SteveMayze/LED_Chain/doc/20201027_183659.jpg

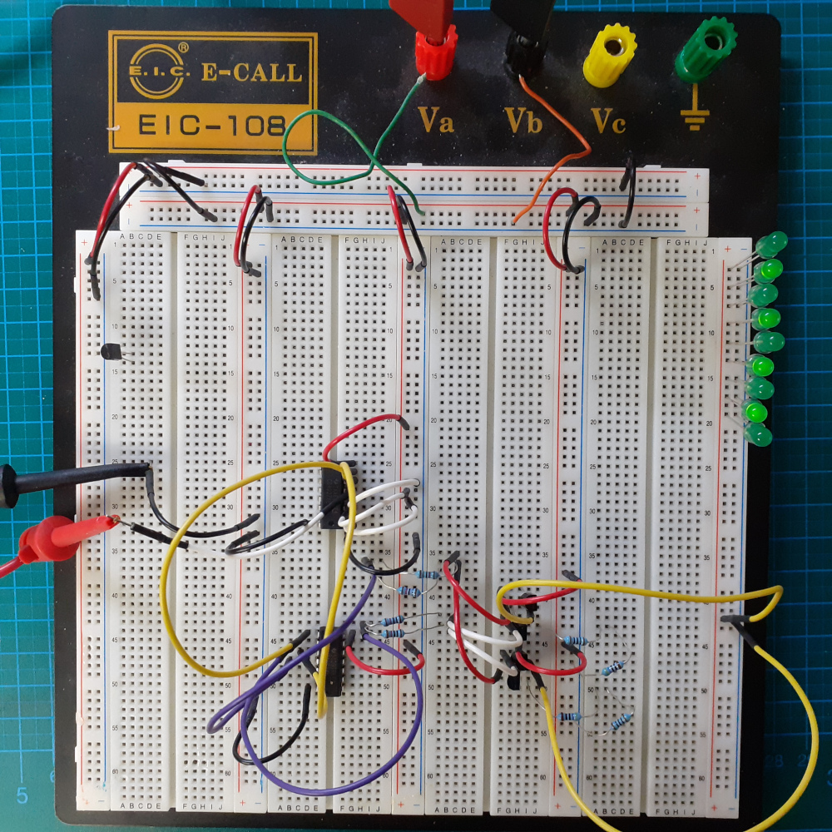
doc/20201027_183659.jpg
