SteveMayze/LED_Chain/doc/2021-10-09_17-44-00.jpg

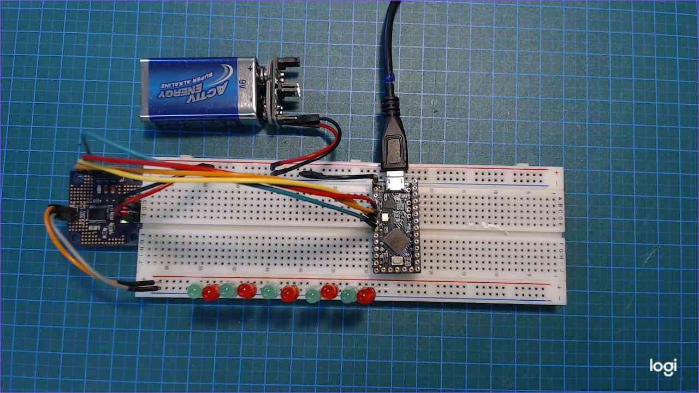
doc/2021-10-09_17-44-00.jpg
