SteveMayze/LED_Chain/README.md

# LED_Chain
An experiment in driving a chain of LEDs
