SteveMayze/LED_Chain/doc/2021-09-12_13-22-11.jpg

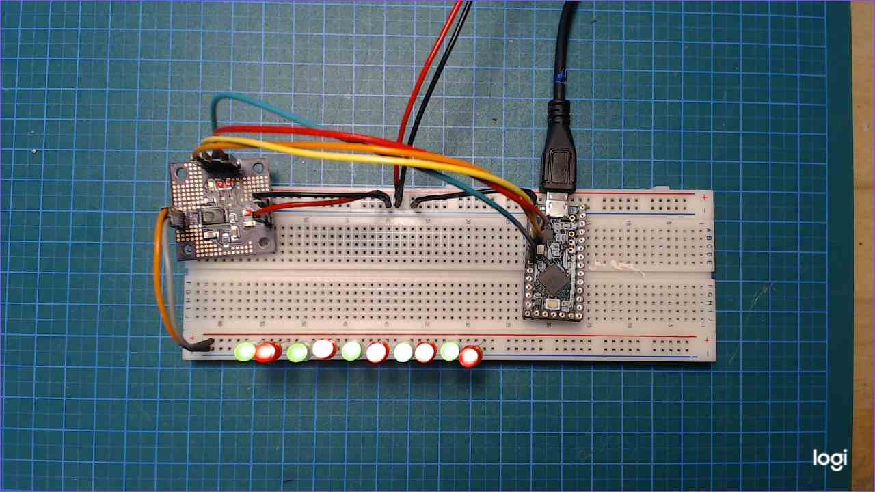
doc/2021-09-12_13-22-11.jpg
