SteveMayze/LED_Chain/doc/20201024_185740.jpg

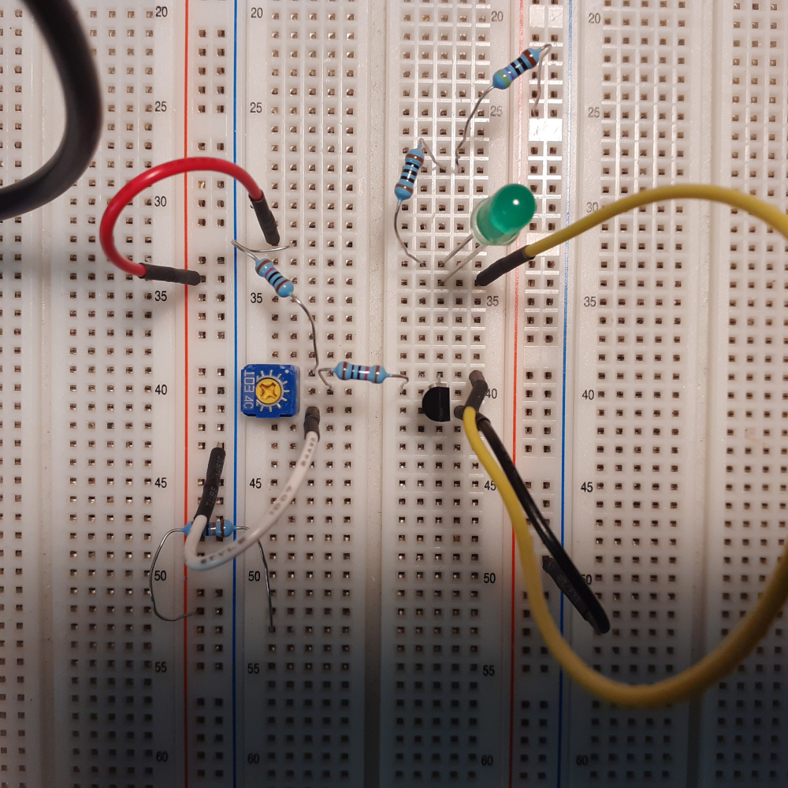
doc/20201024_185740.jpg
