SteveMayze/LED_Chain/doc/20201025_183352.jpg

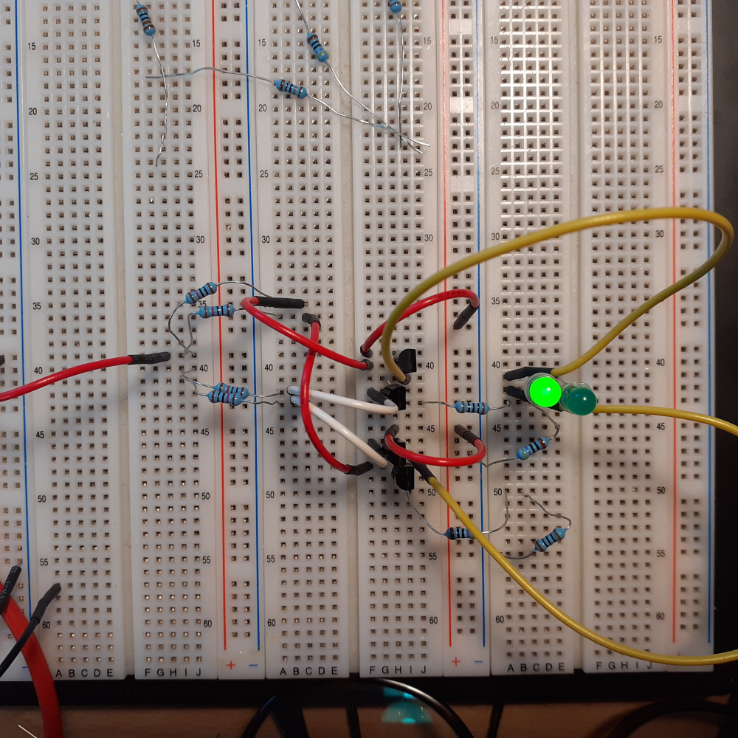
doc/20201025_183352.jpg
