SteveMayze/LED_Chain/doc/BreathPulse.png

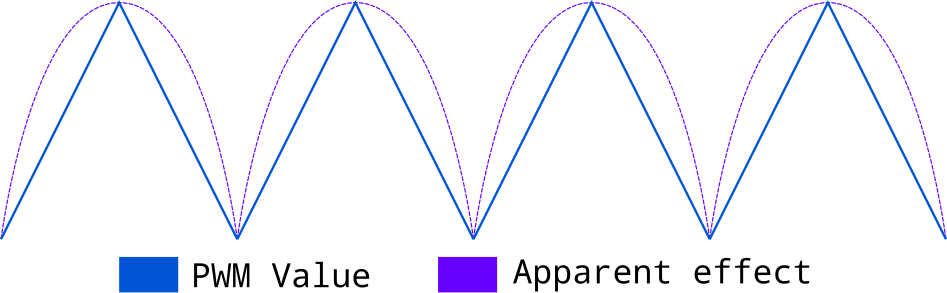
doc/BreathPulse.png
