SteveMayze/LED_Chain/doc/Falstad-Circuit.png

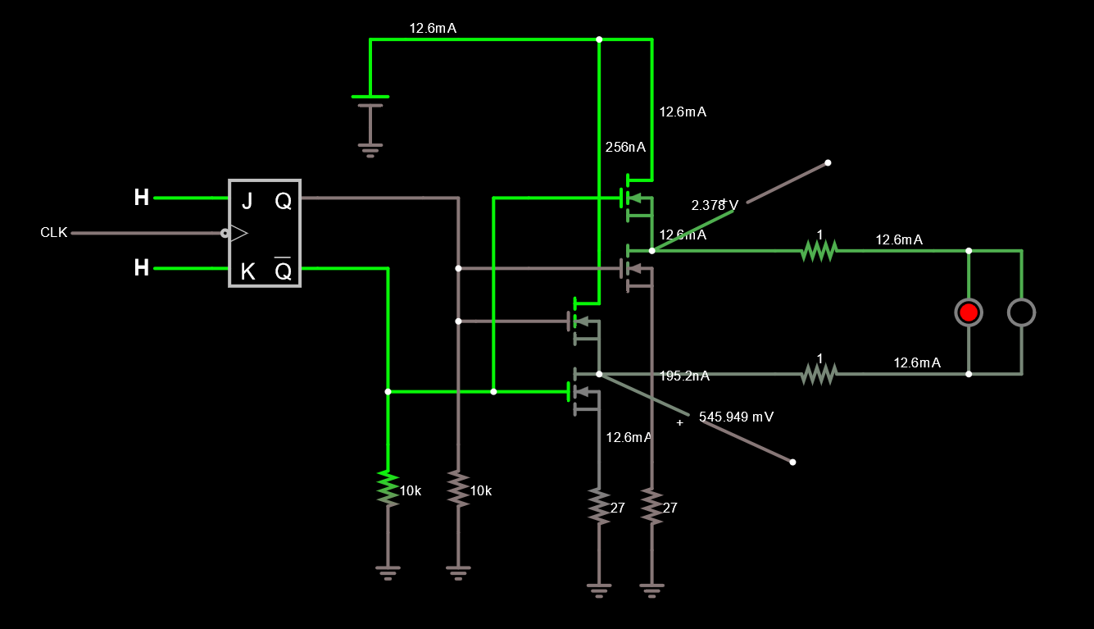
doc/Falstad-Circuit.png
