SteveMayze/LED_Chain/doc/LED_Chain_Bus.png

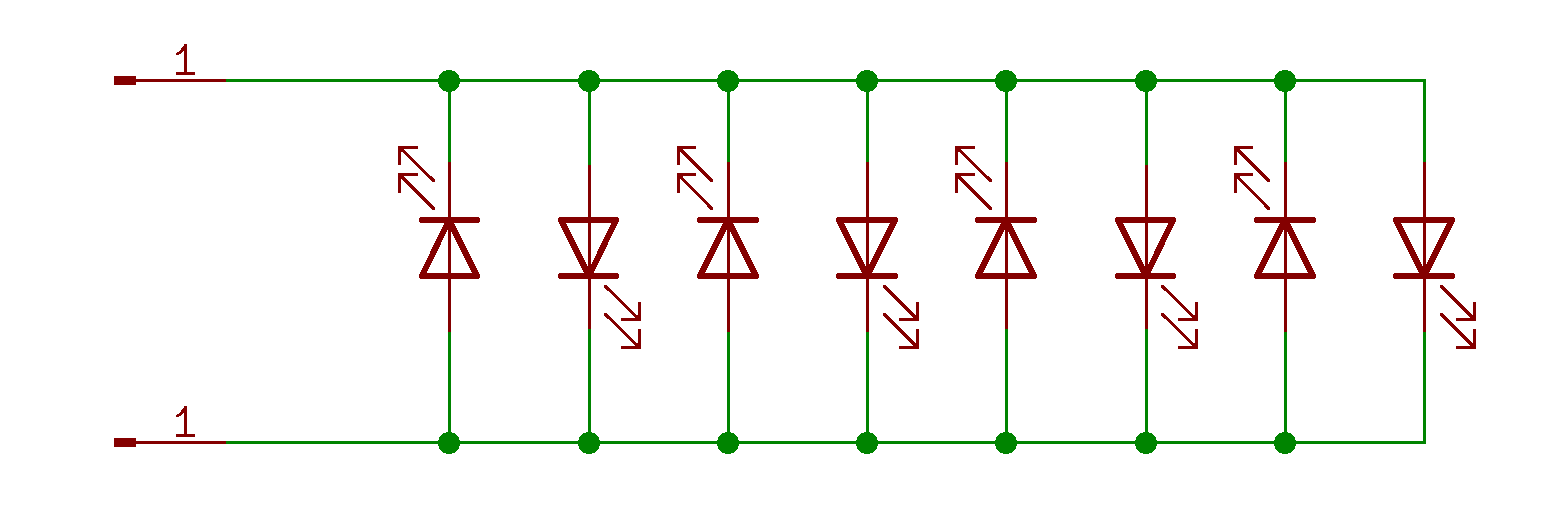
doc/LED_Chain_Bus.png
