SteveMayze/LED_Chain/doc/R_LED_Calc.png

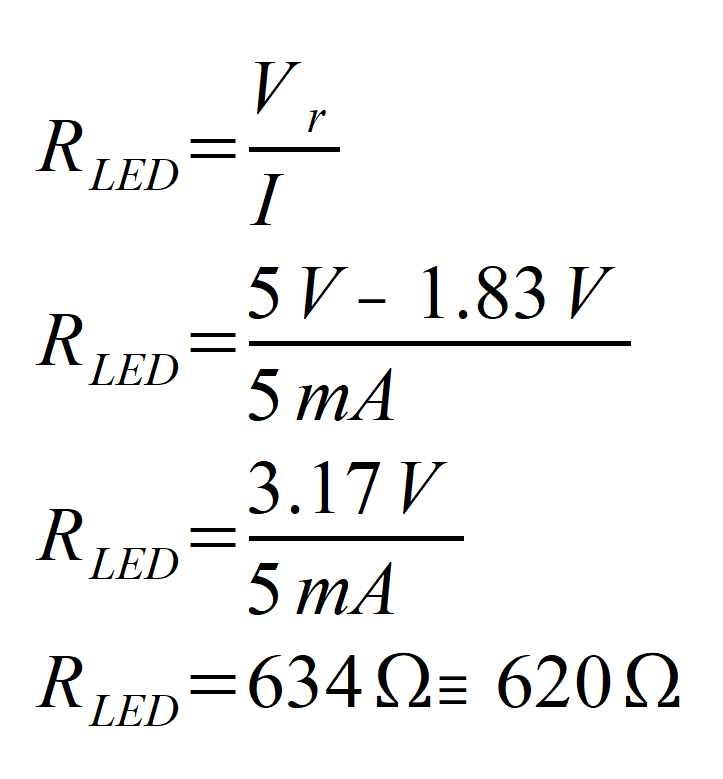
doc/R_LED_Calc.png
