SteveMayze/LED_Chain/Fritzing/motorDriver.png

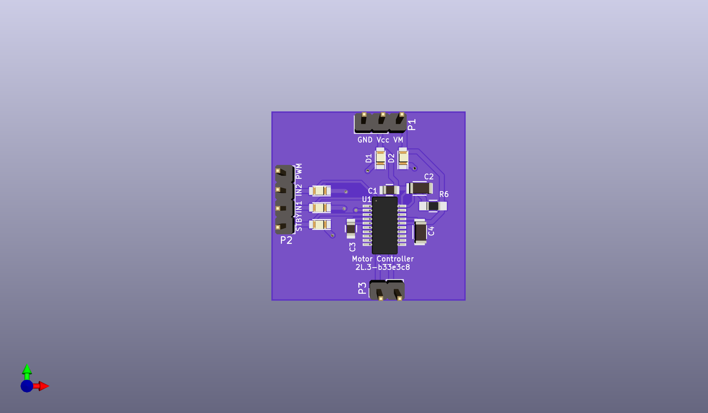
Fritzing/motorDriver.png
