SteveMayze/LED_Chain/Fritzing/Teensy Gogogo Connection_bb.png

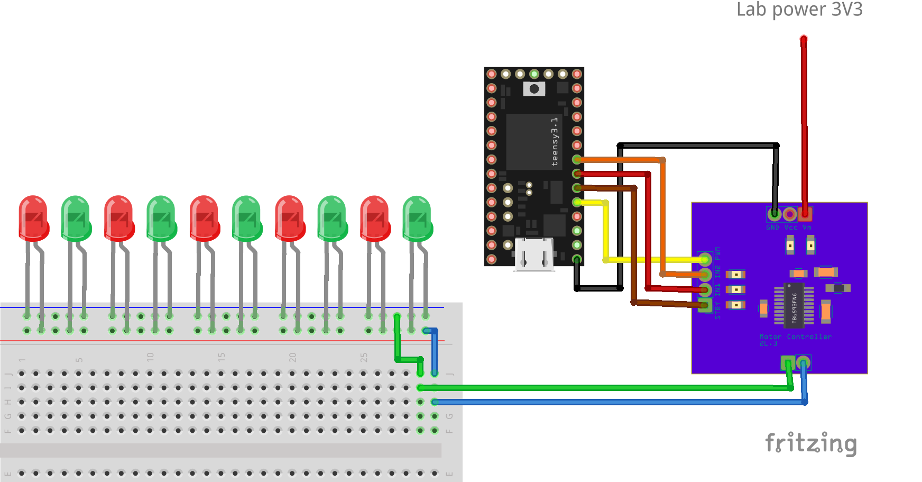
Fritzing/Teensy Gogogo Connection_bb.png
