SteveMayze/LED_Chain/(list of files, drawings)

Other design files:
Fritzing/Fzz/Teensy Gogogo Connection.fz
Fritzing/Teensy Gogogo Connection.fzz
