SteveMayze/LED_Chain/kicad/LED_Chain.kicad_pcb

## KiCad design kicad/LED_Chain.kicad_pcb (2024-11-23)

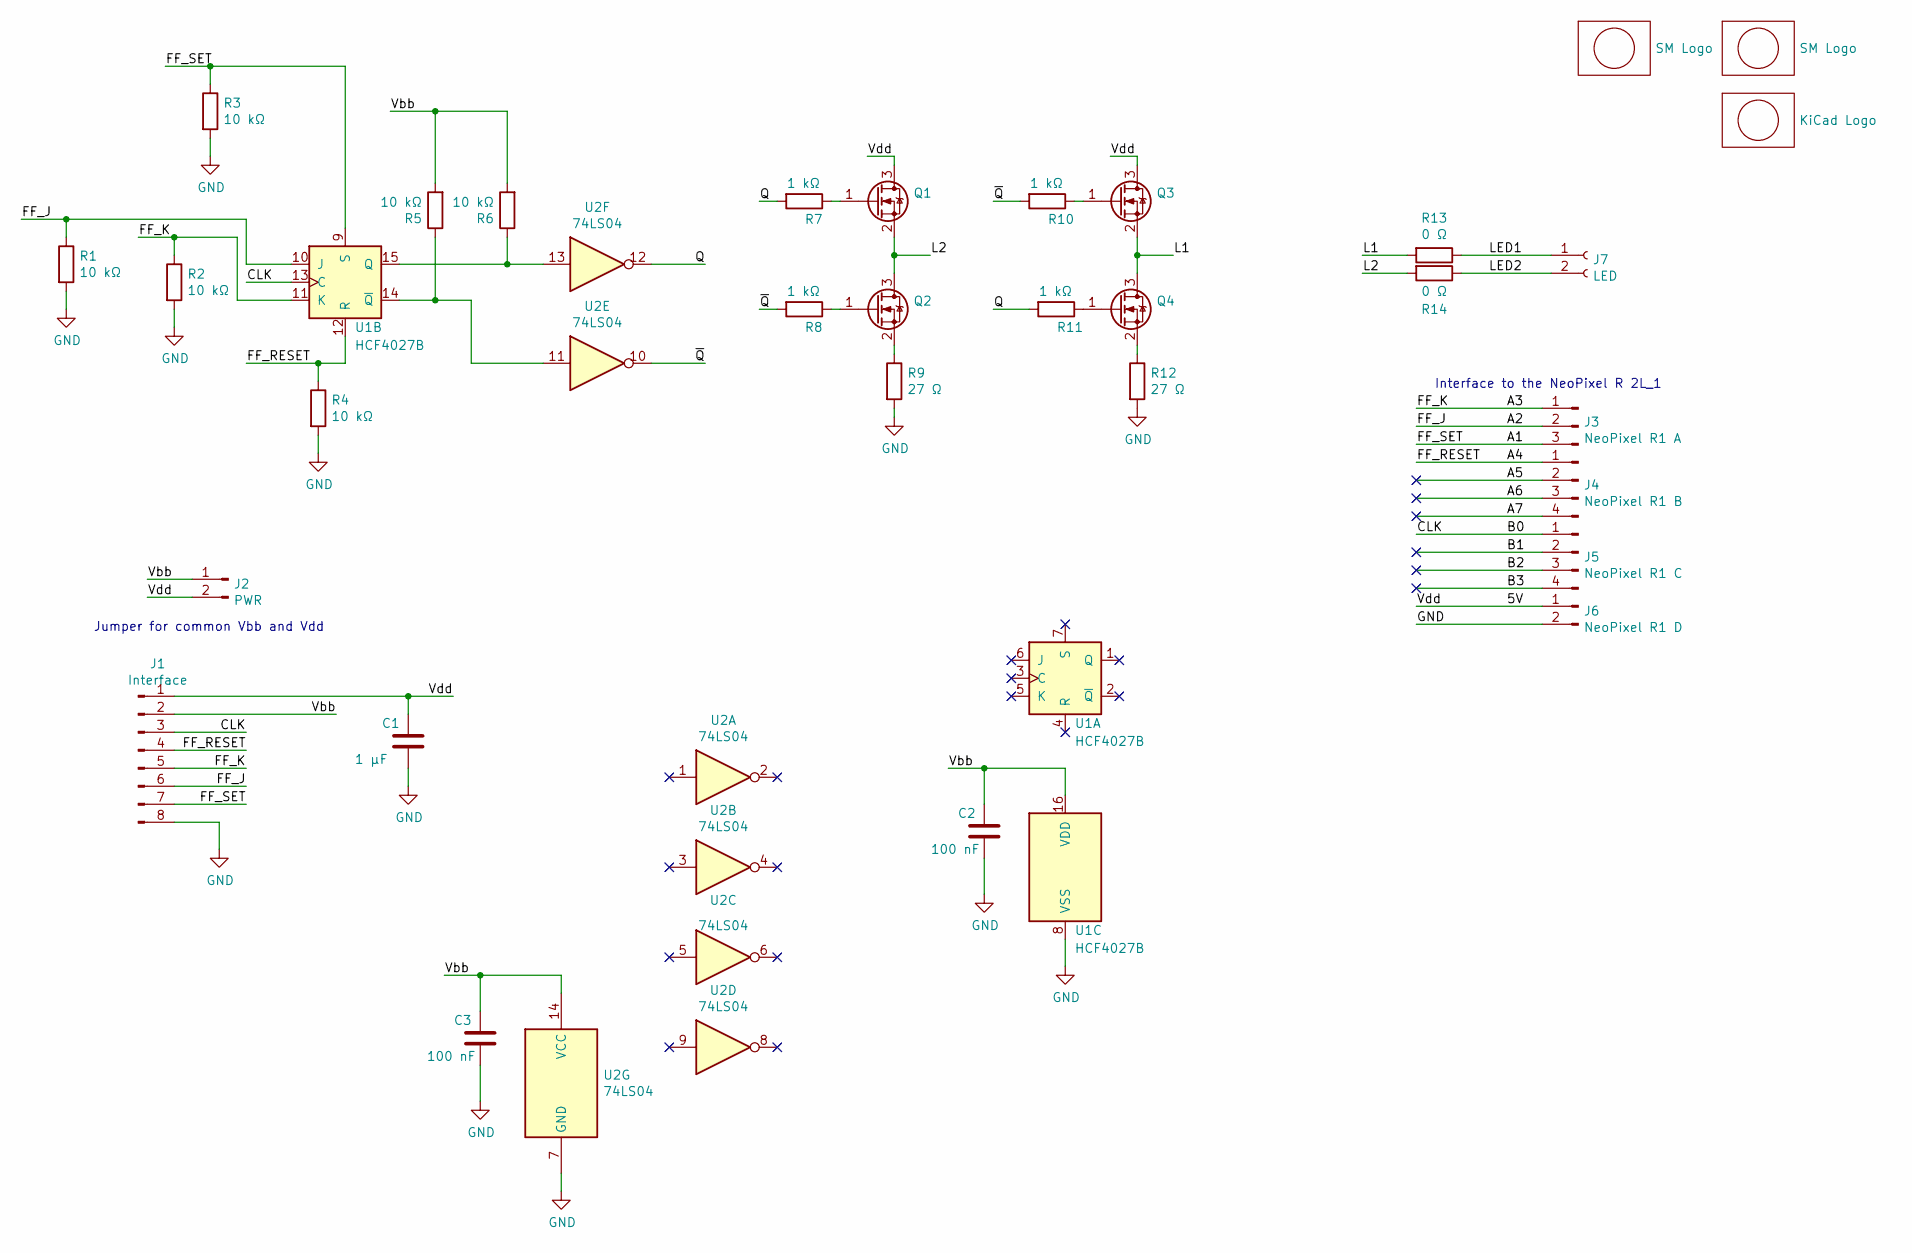
[picture p12: schematic LED_Chain.kicad_sch]

Parts:
C1: 1 μF; C_0805_2012Metric
C2, C3: 100 nF; C_0805_2012Metric
J1: Interface; PinHeader_1x08_P2.54mm_Horizontal
J2: PWR; PinHeader_1x02_P2.54mm_Vertical
J3: NeoPixel R1 A; PinHeader_1x03_P2.54mm_Vertical
J4: NeoPixel R1 B; PinHeader_1x04_P2.54mm_Vertical
J5: NeoPixel R1 C; PinHeader_1x04_P2.54mm_Vertical
J6: NeoPixel R1 D; PinHeader_1x02_P2.54mm_Vertical
J7: LED; TerminalBlock_bornier-2_P5.08mm
Lg1, Lg3: SM Logo; MyBasic_rounded_50_1
Lg2: KiCad Logo; KiCad-Logo2_5mm_SilkScreen
Q1, Q2, Q3, Q4: IRLML2502; SOT-23
R1, R2, R3, R4, R5, R6: 10 kΩ; R_0805_2012Metric
R7, R8, R10, R11: 1 kΩ; R_0805_2012Metric
R9, R12: 27 Ω; R_0805_2012Metric
R13, R14: 0 Ω; R_0805_2012Metric
U1: HCF4027B; SO-16-N
U2: 74LS04; SOIC-14

Connections:
/5V: C1.1, J1.1, J2.2, J6.1, Q1.3 (D), Q3.3 (D)
/A1: J1.7, J3.3, R3.1, U1.9 (S)
/A2: J1.6, J3.2, R1.1, U1.10 (J)
/A3: J1.5, J3.1, R2.1, U1.11 (K)
/A4: J1.4, J4.1, R4.1, U1.12 (R)
/A5: J4.2
/A6: J4.3
/A7: J4.4
/B0: J1.3, J5.1, U1.13 (C)
/B1: J5.2
/B2: J5.3
/B3: J5.4
/L1: Q3.2 (S), Q4.3 (D), R13.2
/L2: Q1.2 (S), Q2.3 (D), R14.2
/LED1: J7.1, R13.1
/LED2: J7.2, R14.1
/Q: R7.2, R11.2, U2.12
/Vbb: C2.1, C3.1, J1.2, J2.1, R5.2, R6.2, U1.16 (VDD), U2.14 (VCC)
/~Q: R8.2, R10.2, U2.10
GND: C1.2, C2.2, C3.2, J1.8, J6.2, R1.2, R2.2, R3.2, R4.2, R9.2, R12.2, U1.8 (VSS), U2.7 (GND)
unnamed: Q1.1 (G), R7.1
unnamed: Q2.1 (G), R8.1
unnamed: Q2.2 (S), R9.1
unnamed: Q3.1 (G), R10.1
unnamed: Q4.1 (G), R11.1
unnamed: Q4.2 (S), R12.1
unnamed: R6.1, U1.15 (Q), U2.13
unnamed: R5.1, U1.14 (~Q), U2.11

Notes on the sheet:
Jumper for common Vbb and Vdd
Interface to the NeoPixel R 2L_1

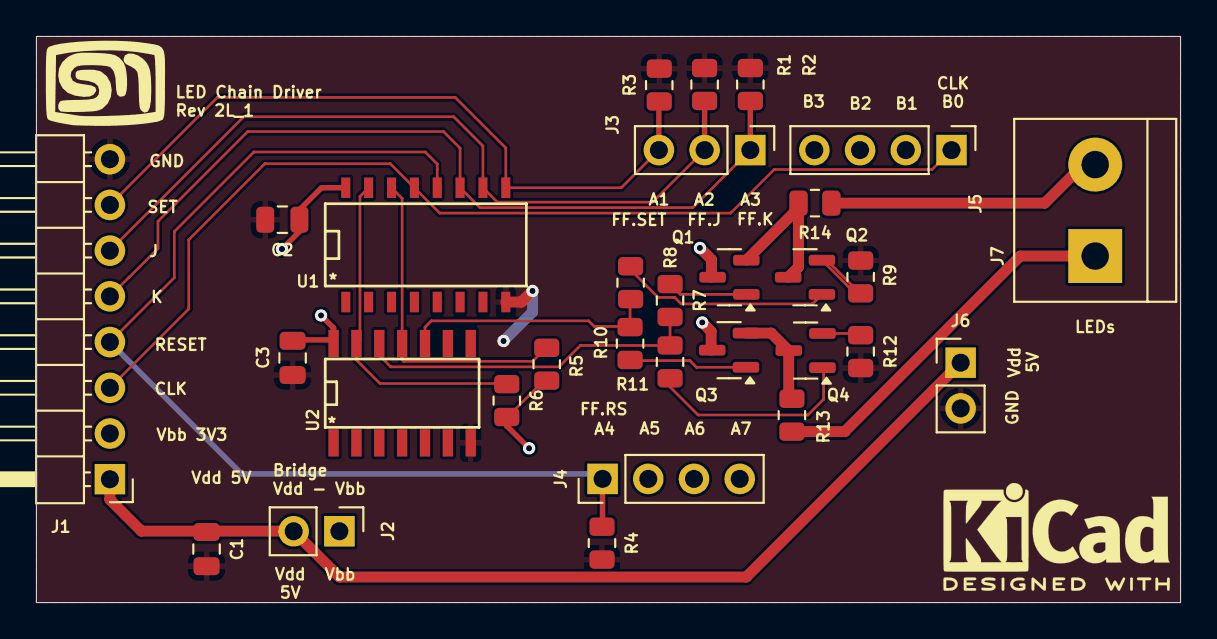
[picture p13: board LED_Chain.kicad_pcb from above]

Board: 2 copper layers, 63.6 x 31.5 mm, 33 parts (1 on the bottom side), 22 nets.
