SteveMayze/LED_Chain/Fritzing/DoubleBreatheResult.png

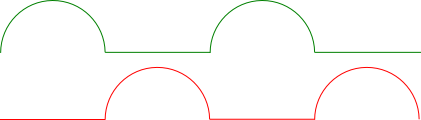
Fritzing/DoubleBreatheResult.png
