SteveMayze/LED_Chain/(commit log)

2020-10-21 Started the schematic
    [LED_Chain.kicad_pcb, LED_Chain.sch]
2020-10-24 Schematic and initial layout
    [LED_Chain.kicad_pcb, LED_Chain.sch]
2020-10-25 Added a buffer resitor to the gates
    [LED_Chain.kicad_pcb, LED_Chain.sch]
2020-11-01 Configuration for 1kHz on pin PB0
2020-11-02 Makes the frequency selection more flexible and corrects the calculation
    [main.c]
2020-11-03 Updated the schematic and started a new layout for the final design
    [LED_Chain.kicad_pcb, LED_Chain.sch]
2020-11-08 Another layout attempt - changes to pin layout for Neopixel interface
    [LED_Chain.kicad_pcb, LED_Chain.sch]
2020-11-09 Completed the layout
    [LED_Chain.kicad_pcb, LED_Chain.sch]
2020-11-09 Completed layout and sent to OSH Park
    [LED_Chain-B_Cu.gbr, LED_Chain-B_Mask.gbr, LED_Chain-B_Paste.gbr, LED_Chain-B_SilkS.gbr, LED_Chain-Edge_Cuts.gbr, LED_Chain-F_Cu.gbr, LED_Chain-F_Mask.gbr, LED_Chain-F_Paste.gbr]
2020-11-10 Changed the pin allocation to match the PCB changes and some animation timing
2020-12-21 Makes a small correction to the labelling of the Vbb-Vdd bridge
    [LED_Chain.kicad_pcb]
2020-12-21 Fixes the pin association on J3
    [LED_Chain.kicad_pcb, LED_Chain.sch]
2020-12-22 Revert "Fixes the pin association on J3"
    This reverts commit 2cc36517f423e818af2cf15adf9433c164440afc.
    [LED_Chain.kicad_pcb, LED_Chain.sch]
2020-12-22 Corrects the pin assignment so that no hardware change is required
    The original pin assignments A1 and A3 have been swapped for simpler layout on the board from what was originally imagined. Rather than making a hardware change, the firmware now has the functions for A1 and A3 swapped over.
2021-09-04 Uses a motocontroller as a LED driver and ports the sample from the AT1614
2021-09-05 Adds two more _breathe_ annimations using PWM
2021-09-05 Starting a Fritzing connection
    [Teensy Gogogo Connection.fzz]
2021-09-09 Assessing KiCad to Fritzing work steps
2021-10-08 Documentation update
    [Teensy Gogogo Connection.fz, Teensy Gogogo Connection.fzz]
2024-11-23 Upgraded basic symbols and footprints
    [LED_Chain.kicad_pcb, LED_Chain.kicad_sch]
2024-11-23 Updated for V8 KiCad
    [LED_Chain.kicad_pcb, LED_Chain.kicad_sch]
2024-11-23 V8 update
    [LED_Chain.kicad_pcb]
2024-11-24 Started the 12V of the LED Chain
    [LED_Chain_12V.kicad_pcb, LED_Chain_12V.kicad_sch]
